crazyquark/bSafe/hardware/bSafe-charger-block/plots/bSafe-charger-block__Assembly.pdf

1 | 2 | 3 | 4 | 5 | 6

A

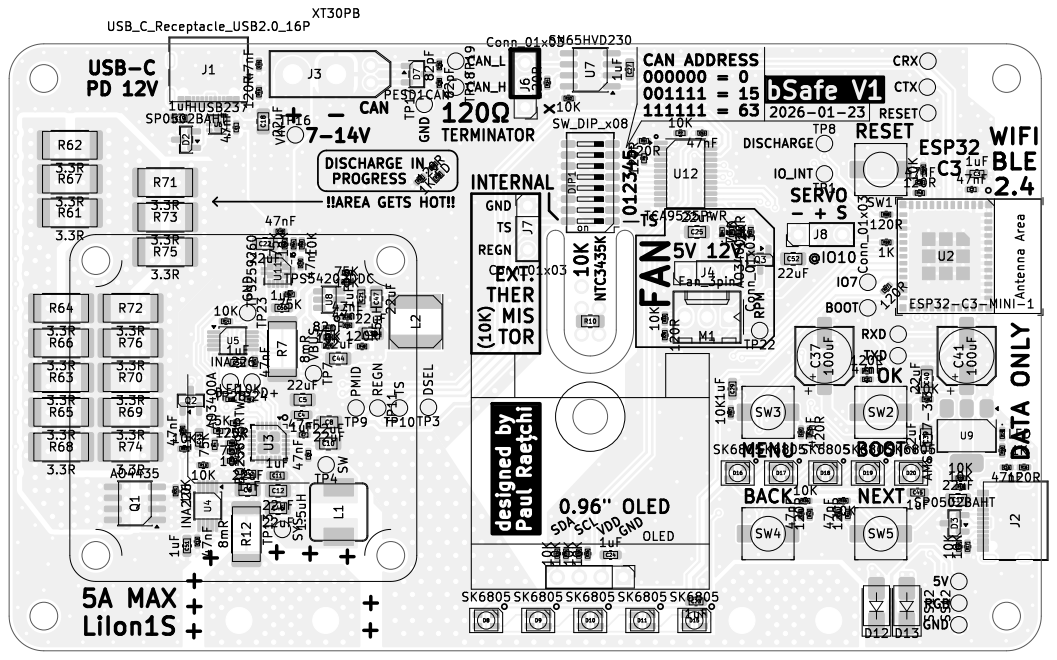
[picture p1: page 1]

!!AREA GETS HOT!! þÿ120©

REGN EXT. THER MIS

Id: /1 Title: File: bSafe-charger-block.kicad_pcb Sheet: Black And White TOP

CFG0 CFG1 1 | 2 | 3 | 4 | 5 | 6 1 | 2 | 3 | 4 | 5 | 6 ABCD | ABCD Date: KiCad | E.D.A. 9.0.7 Size: A4 | Rev:

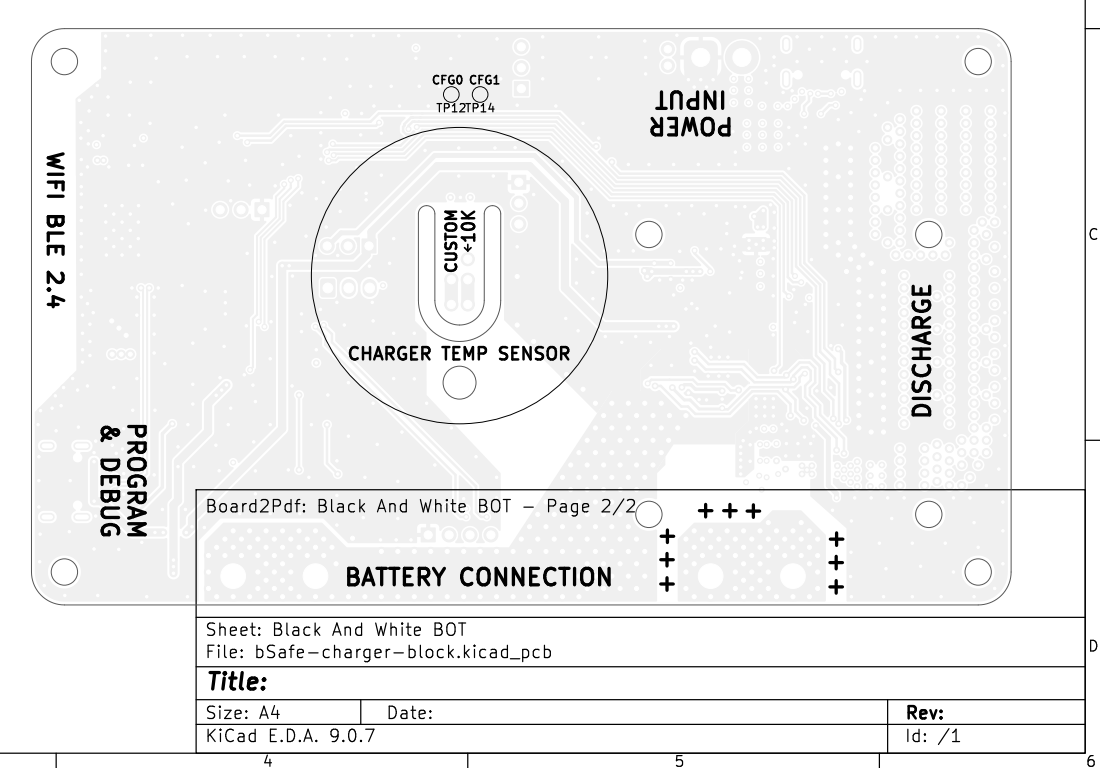
[picture p2: page 2]
CHARGER TEMP SENSOR; DISCHARGE WIFI BLE 2.4; &PROGRAM DEBUG; BATTERY CONNECTION; Id: /1 Title: File: bSafe-charger-block.kicad_pcb Sheet: Black; And; White; BOT Board2Pdf:; Black; BOT -; Page 2/2
