crazyquark/bSafe/hardware/bSafe-charger-block/bSafe-charger-block.kicad_pcb

## KiCad design hardware/bSafe-charger-block/bSafe-charger-block.kicad_pcb (2026-02-03)

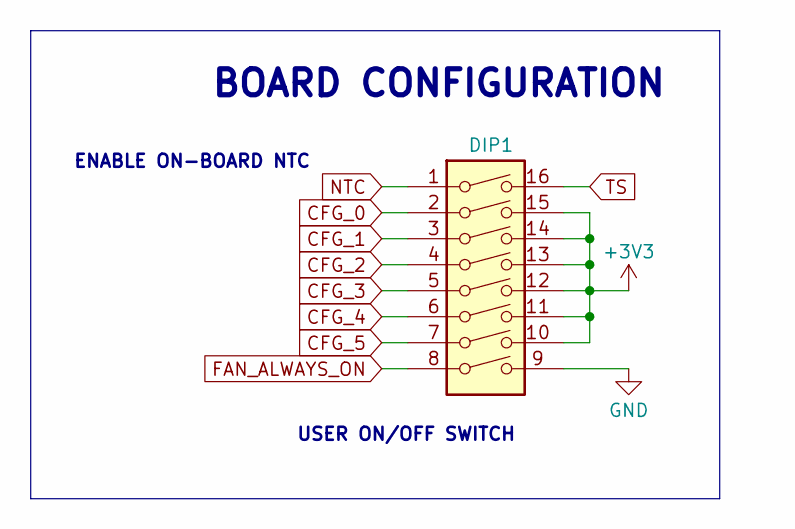
[picture p3: schematic config.kicad_sch]

Parts:
DIP1: SW_DIP_x08; SW_DIP_SPSTx08_Slide_Copal_CHS-08A_W5.08mm_P1.27mm_JPin

Connections:
+3V3: DIP1.10, DIP1.11, DIP1.12, DIP1.13, DIP1.14, DIP1.15; also elsewhere on the board
CFG_0: DIP1.2; also elsewhere on the board
CFG_1: DIP1.3; also elsewhere on the board
CFG_2: DIP1.4; also elsewhere on the board
CFG_3: DIP1.5; also elsewhere on the board
CFG_4: DIP1.6; also elsewhere on the board
CFG_5: DIP1.7; also elsewhere on the board
FAN_ALWAYS_ON: DIP1.8; also elsewhere on the board
GND: DIP1.9; also elsewhere on the board
NTC: DIP1.1; also elsewhere on the board
TS: DIP1.16; also elsewhere on the board

Notes on the sheet:
USER ON/OFF SWITCH
ENABLE ON-BOARD NTC
BOARD CONFIGURATION

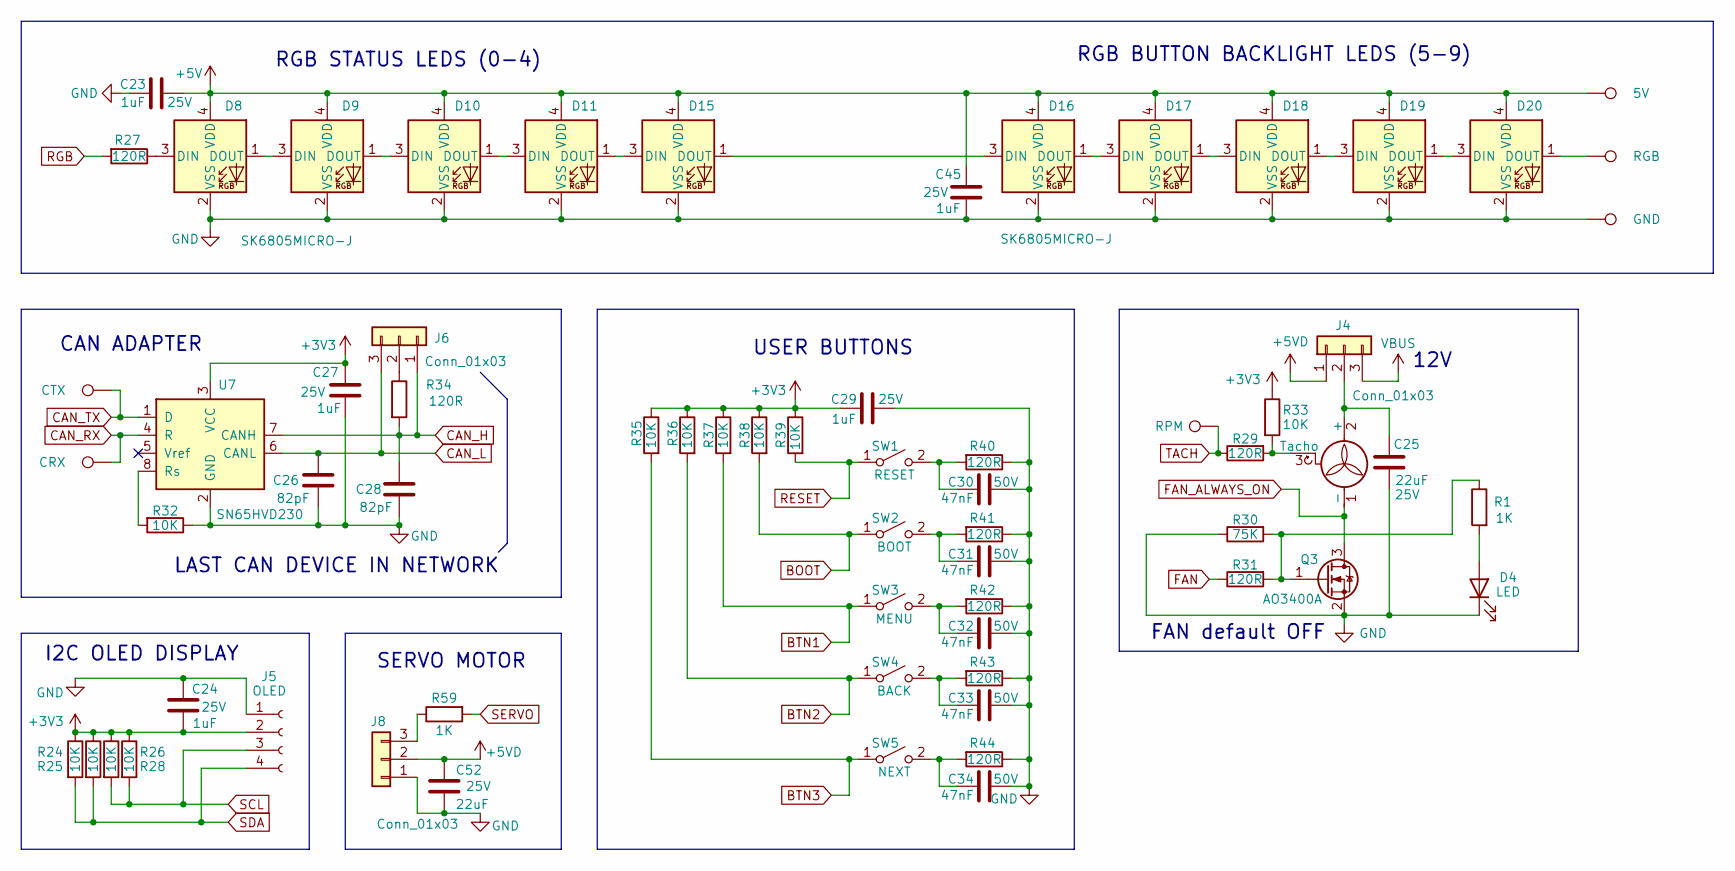
[picture p4: schematic interface.kicad_sch]

Parts:
C23, C24, C27, C29, C45: 1uF; C_0603_1608Metric; Voltage 25V
C25, C52: 22uF; C_0805_2012Metric; Voltage 25V
C26, C28: 82pF; C_0402_1005Metric
C30, C31, C32, C33, C34: 47nF; C_0402_1005Metric; Voltage 50V
D4: LED; LED_0402_1005Metric
D8, D9, D10, D11, D15, D16, D17, D18, D19, D20: SK6805MICRO-J; LED_SK6805_PLCC4_2.4x2.7mm_P1.3mm
J4, J6, J8: Conn_01x03; PinHeader_1x03_P2.54mm_Vertical
J5: OLED; Display_128x64_096_I2C
M1: Fan_3pin; Molex_KK-254_AE-6410-03A_1x03_P2.54mm_Vertical
Q3: AO3400A; SOT-23; JLCPCB C20917
R1, R59: 1K; R_0402_1005Metric
R24, R25, R26, R28, R32, R33, R35, R36, R37, R38, R39: 10K; R_0402_1005Metric
R27, R29, R31, R34, R40, R41, R42, R43, R44: 120R; R_0402_1005Metric
R30: 75K; R_0402_1005Metric
SW1: RESET; TS665WS
SW2: BOOT; TS665WS
SW3: MENU; TS665WS
SW4: BACK; TS665WS
SW5: NEXT; TS665WS
TP20: CTX; TestPoint_Pad_D1.5mm
TP21: CRX; TestPoint_Pad_D1.5mm
TP22: RPM; TestPoint_Pad_D1.5mm
TP25: 5V; TestPoint_Pad_D1.5mm
TP26: RGB; TestPoint_Pad_D1.5mm
TP27: GND; TestPoint_Pad_D1.5mm
U7: SN65HVD230; SOIC-8_3.9x4.9mm_P1.27mm

Connections:
+3V3: C24.2, C27.1, C29.2, J5.2, R24.1, R25.1, R26.1, R28.1, R33.1, R35.1, R36.1, R37.1, R38.1, R39.1, U7.3 (VCC); also elsewhere on the board
+5V: C23.1, C45.1, D8.4 (VDD), D9.4 (VDD), D10.4 (VDD), D11.4 (VDD), D15.4 (VDD), D16.4 (VDD), D17.4 (VDD), D18.4 (VDD), D19.4 (VDD), D20.4 (VDD), TP25.1; also elsewhere on the board
+5VD: C52.2, J4.1, J8.2; also elsewhere on the board
BOOT: R38.2, SW2.1 (A); also elsewhere on the board
BTN1: R37.2, SW3.1 (A); also elsewhere on the board
BTN2: R36.2, SW4.1 (A); also elsewhere on the board
BTN3: R35.2, SW5.1 (A); also elsewhere on the board
CAN_H: C28.1, J6.1, R34.2, U7.7 (CANH); also elsewhere on the board
CAN_L: C26.1, J6.3, U7.6 (CANL); also elsewhere on the board
CAN_RX: TP21.1, U7.4 (R); also elsewhere on the board
CAN_TX: TP20.1, U7.1 (D); also elsewhere on the board
FAN: R31.1; also elsewhere on the board
FAN_ALWAYS_ON: M1.1 (-), Q3.3 (D); also elsewhere on the board
GND: C23.2, C24.1, C25.2, C26.2, C27.2, C28.2, C29.1, C30.1, C31.1, C32.1, C33.1, C34.1, C45.2, C52.1, D4.1 (K), D8.2 (VSS), D9.2 (VSS), D10.2 (VSS), D11.2 (VSS), D15.2 (VSS), D16.2 (VSS), D17.2 (VSS), D18.2 (VSS), D19.2 (VSS), D20.2 (VSS), J5.1, J8.1, Q3.2 (S), R30.1, R32.1, R40.1, R41.1, R42.1, R43.1, R44.1, TP27.1, U7.2 (GND); also elsewhere on the board
unnamed: D4.2 (A), R1.2
unnamed: D8.3 (DIN), R27.1
unnamed: D8.1 (DOUT), D9.3 (DIN)
unnamed: D9.1 (DOUT), D10.3 (DIN)
unnamed: D10.1 (DOUT), D11.3 (DIN)
unnamed: D11.1 (DOUT), D15.3 (DIN)
unnamed: D15.1 (DOUT), D16.3 (DIN)
unnamed: D16.1 (DOUT), D17.3 (DIN)
unnamed: D17.1 (DOUT), D18.3 (DIN)
unnamed: D18.1 (DOUT), D19.3 (DIN)
unnamed: D19.1 (DOUT), D20.3 (DIN)
unnamed: D20.1 (DOUT), TP26.1
unnamed: C25.1, J4.2, M1.2 (+)
unnamed: J6.2, R34.1
unnamed: J8.3, R59.1
unnamed: M1.3 (Tacho), R29.2, R33.2
unnamed: Q3.1 (G), R1.1, R30.2, R31.2
unnamed: C30.2, R40.2, SW1.2 (B)
unnamed: C31.2, R41.2, SW2.2 (B)
unnamed: C32.2, R42.2, SW3.2 (B)
unnamed: C33.2, R43.2, SW4.2 (B)
unnamed: C34.2, R44.2, SW5.2 (B)
unnamed: R32.2, U7.8 (Rs)
RESET: R39.2, SW1.1 (A); also elsewhere on the board
RGB: R27.2; also elsewhere on the board
SCL: J5.3, R26.2, R28.2; also elsewhere on the board
SDA: J5.4, R24.2, R25.2; also elsewhere on the board
SERVO: R59.2; also elsewhere on the board
TACH: R29.1, TP22.1; also elsewhere on the board
VBUS: J4.3; also elsewhere on the board

Notes on the sheet:
I2C OLED DISPLAY
CAN ADAPTER
RGB STATUS LEDS (0-4)
SERVO MOTOR
RGB BUTTON BACKLIGHT LEDS (5-9)
FAN default OFF
12V
LAST CAN DEVICE IN NETWORK
USER BUTTONS

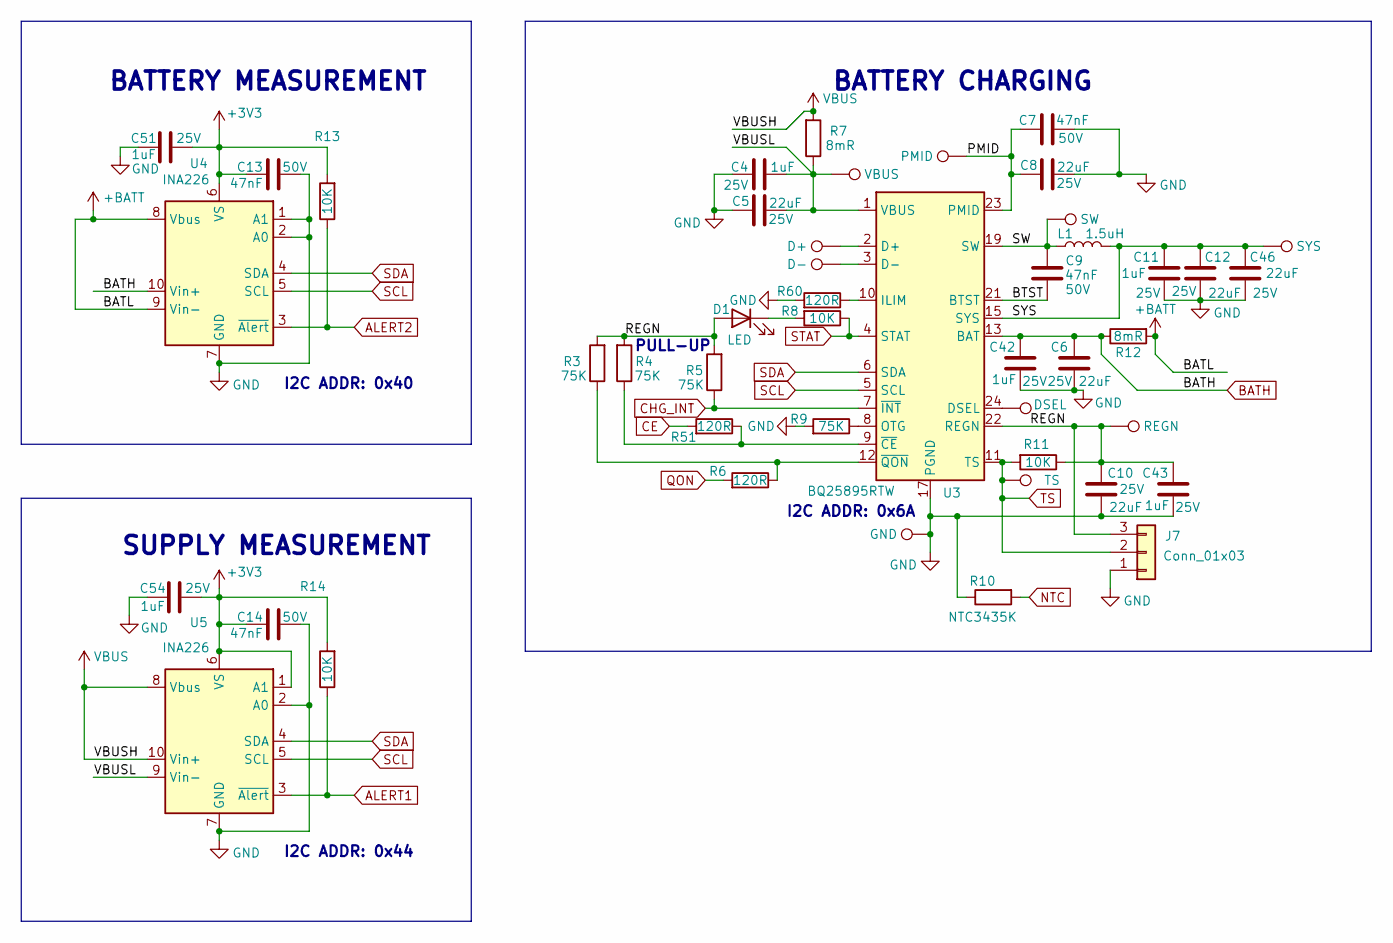
[picture p5: schematic charge.kicad_sch]

Parts:
C4, C11, C42, C43, C51, C54: 1uF; C_0603_1608Metric; Voltage 25V
C5, C6, C8, C10, C12, C46: 22uF; C_0805_2012Metric; Voltage 25V
C7, C9, C13, C14: 47nF; C_0402_1005Metric; Voltage 50V
D1: LED; LED_0402_1005Metric
J7: Conn_01x03; PinHeader_1x03_P2.54mm_Vertical
L1: 1.5uH; L_Sumida_CDMC6D28_7.25x6.5mm; JLCPCB C5189745
R3, R4, R5, R9: 75K; R_0402_1005Metric
R6, R51, R60: 120R; R_0402_1005Metric
R7, R12: 8mR; R_2512_6332Metric_Pad1.40x3.35mm_HandSolder
R8, R11, R13, R14: 10K; R_0402_1005Metric
R10: NTC3435K; R_0805_2012Metric_Pad1.20x1.40mm_HandSolder
TP3: DSEL; TestPoint_Pad_D1.5mm
TP4: SW; TestPoint_Pad_D1.5mm
TP7: VBUS; TestPoint_Pad_D1.5mm
TP9: PMID; TestPoint_Pad_D1.5mm
TP10: TS; TestPoint_Pad_D1.5mm
TP11: REGN; TestPoint_Pad_D1.5mm
TP13: SYS; TestPoint_Pad_D1.5mm
TP23: GND; TestPoint_Pad_D1.5mm
TP24: D+; TestPoint_Pad_D1.5mm
TP28: D-; TestPoint_Pad_D1.5mm
U3: BQ25895RTW; Texas_RTW_WQFN-24-1EP_4x4mm_P0.5mm_EP2.7x2.7mm_ThermalVias
U4, U5: INA226; VSSOP-10_3x3mm_P0.5mm

Connections:
+3V3: C13.2, C14.2, C51.1, C54.1, R13.2, R14.2, U4.6 (VS), U5.1 (A1), U5.6 (VS); also elsewhere on the board
+BATT: R12.2, U4.8 (Vbus), U4.9 (Vin-)
/charge/BTST: C9.1, U3.21 (BTST)
/charge/PMID: C7.2, C8.1, TP9.1, U3.23 (PMID)
/charge/REGN: C10.2, C43.2, D1.2 (A), J7.3, R3.2, R4.2, R5.2, R11.1, TP11.1, U3.22 (REGN)
/charge/SW: C9.2, L1.1, TP4.1, U3.19 (SW), U3.20 (SW)
/charge/SYS: C11.2, C12.1, C46.1, L1.2, TP13.1, U3.15 (SYS), U3.16 (SYS)
/charge/VBUSL: C4.1, C5.2, R7.1, TP7.1, U3.1 (VBUS), U5.9 (Vin-)
ALERT1: R14.1, U5.3 (~Alert); also elsewhere on the board
ALERT2: R13.1, U4.3 (~Alert); also elsewhere on the board
BATH: C6.1, C42.2, R12.1, U3.13 (BAT), U3.14 (BAT), U4.10 (Vin+); also elsewhere on the board
CE: R51.2; also elsewhere on the board
CHG_INT: R5.1, U3.7 (~INT); also elsewhere on the board
GND: C4.2, C5.1, C6.2, C7.1, C8.2, C10.1, C11.1, C12.2, C13.1, C14.1, C42.1, C43.1, C46.2, C51.2, C54.2, J7.1, R9.2, R10.1, R60.2, TP23.1, U3.17 (PGND), U3.18 (PGND), U3.25 (PGND), U4.1 (A1), U4.2 (A0), U4.7 (GND), U5.2 (A0), U5.7 (GND); also elsewhere on the board
NTC: R10.2; also elsewhere on the board
unnamed: D1.1 (K), R8.2
unnamed: TP24.1, U3.2 (D+)
unnamed: TP28.1, U3.3 (D-)
unnamed: TP3.1, U3.24 (DSEL)
unnamed: R60.1, U3.10 (ILIM)
unnamed: R9.1, U3.8 (OTG)
unnamed: R4.1, R51.1, U3.9 (~CE)
unnamed: R3.1, R6.1, U3.12 (~QON)
QON: R6.2; also elsewhere on the board
SCL: U3.5 (SCL), U4.5 (SCL), U5.5 (SCL); also elsewhere on the board
SDA: U3.6 (SDA), U4.4 (SDA), U5.4 (SDA); also elsewhere on the board
STAT: R8.1, U3.4 (STAT); also elsewhere on the board
TS: J7.2, R11.2, TP10.1, U3.11 (TS); also elsewhere on the board
VBUS: R7.2, U5.8 (Vbus), U5.10 (Vin+); also elsewhere on the board

Notes on the sheet:
SUPPLY MEASUREMENT
I2C ADDR: 0x44
I2C ADDR: 0x40
BATTERY CHARGING
I2C ADDR: 0x6A
PULL-UP
BATTERY MEASUREMENT

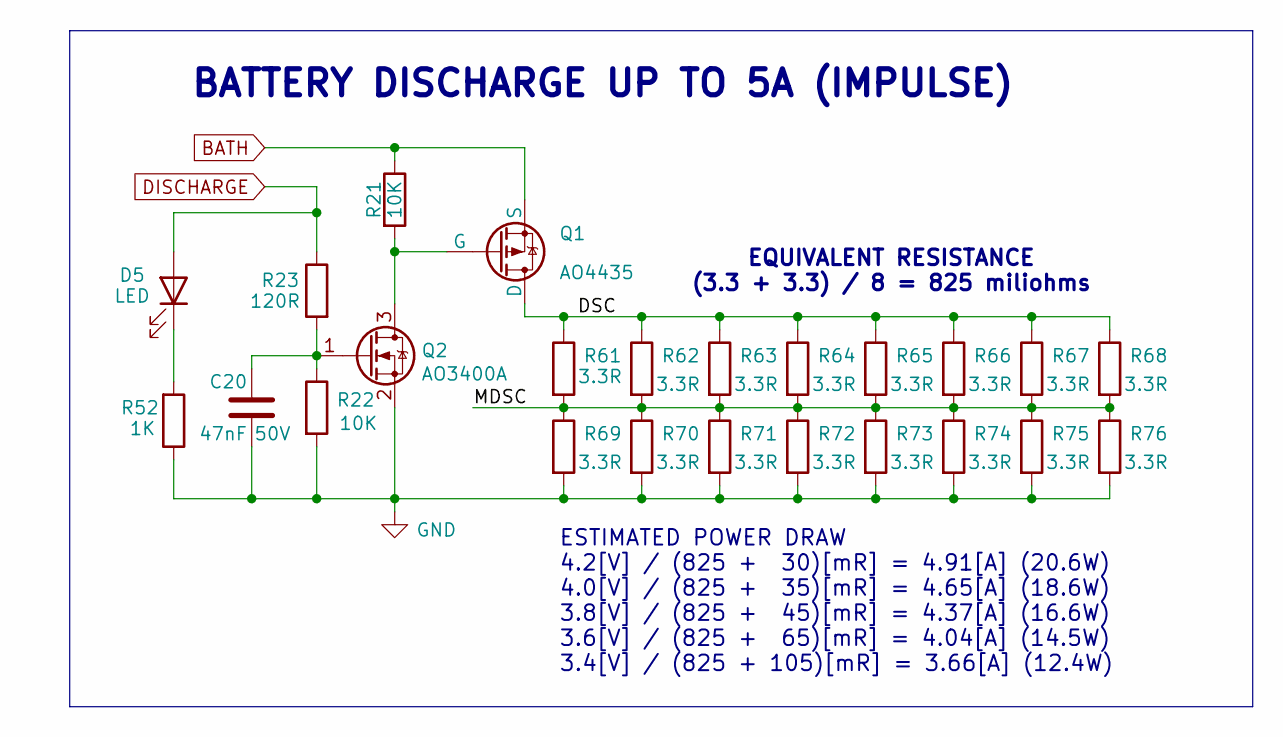
[picture p6: schematic discharge.kicad_sch]

Parts:
C20: 47nF; C_0402_1005Metric; Voltage 50V
D5: LED; LED_0402_1005Metric
Q1: AO4435; SOP-8_3.76x4.96mm_P1.27mm
Q2: AO3400A; SOT-23; JLCPCB C20917
R21, R22: 10K; R_0402_1005Metric
R23: 120R; R_0402_1005Metric
R52: 1K; R_0402_1005Metric
R61, R62, R63, R64, R65, R66, R67, R68, R69, R70, R71, R72, R73, R74, R75, R76: 3.3R; R_2512_6332Metric_Pad1.40x3.35mm_HandSolder

Connections:
/discharge/DSC: Q1.5 (D), Q1.6 (D), Q1.7 (D), Q1.8 (D), R61.1, R62.1, R63.1, R64.1, R65.1, R66.1, R67.1, R68.1
/discharge/MDSC: R61.2, R62.2, R63.2, R64.2, R65.2, R66.2, R67.2, R68.2, R69.1, R70.1, R71.1, R72.1, R73.1, R74.1, R75.1, R76.1
BATH: Q1.1 (S), Q1.2 (S), Q1.3 (S), R21.1; also elsewhere on the board
DISCHARGE: D5.2 (A), R23.1; also elsewhere on the board
GND: C20.2, Q2.2 (S), R22.2, R52.1, R69.2, R70.2, R71.2, R72.2, R73.2, R74.2, R75.2, R76.2; also elsewhere on the board
unnamed: D5.1 (K), R52.2
unnamed: Q1.4 (G), Q2.3 (D), R21.2
unnamed: C20.1, Q2.1 (G), R22.1, R23.2

Notes on the sheet:
EQUIVALENT RESISTANCE (3.3 + 3.3) / 8 = 825 miliohms
ESTIMATED POWER DRAW 4.2[V] / (825 + 30)[mR] = 4.91[A] (20.6W) 4.0[V] / (825 + 35)[mR] = 4.65[A] (18.6W) 3.8[V] / (825 + 45)[mR] = 4.37[A] (16.6W) 3.6[V] / (825 + 65)[mR] = 4.04[A] (14.5W) 3.4[V] / (825 + 105)[mR] = 3.66[A] (12.4W)
BATTERY DISCHARGE UP TO 5A (IMPULSE)

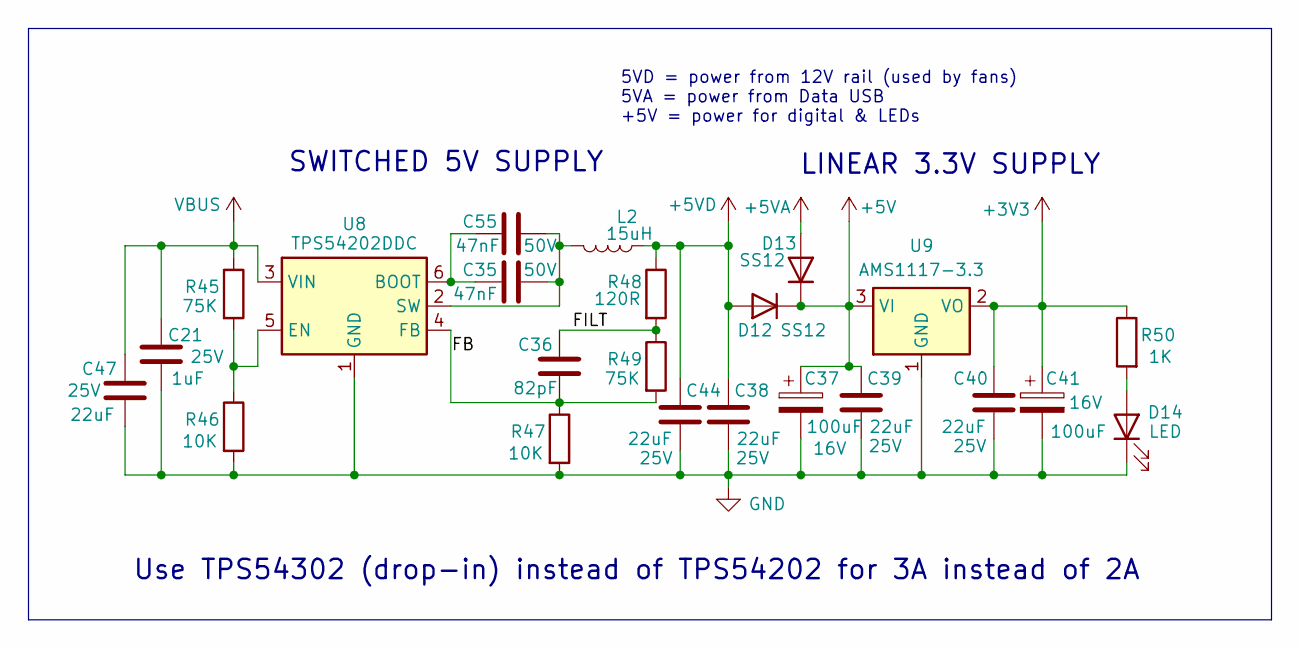
[picture p7: schematic supply.kicad_sch]

Parts:
C21: 1uF; C_0603_1608Metric; Voltage 25V
C35, C55: 47nF; C_0402_1005Metric; Voltage 50V
C36: 82pF; C_0402_1005Metric
C37, C41: 100uF; CP_Elec_6.3x5.4_Nichicon; Voltage 16V
C38, C39, C40, C44, C47: 22uF; C_0805_2012Metric; Voltage 25V
D12, D13: SS12; D_SMA
D14: LED; LED_0402_1005Metric
L2: 15uH; L_Taiyo-Yuden_NR-60xx
R45, R49: 75K; R_0402_1005Metric
R46, R47: 10K; R_0402_1005Metric
R48: 120R; R_0402_1005Metric
R50: 1K; R_0402_1005Metric
U8: TPS54202DDC; SOT-23-6
U9: AMS1117-3.3; SOT-223-3_TabPin2

Connections:
+3V3: C40.1, C41.1, R50.1, U9.2 (VO); also elsewhere on the board
+5V: C37.1, C39.1, D12.1 (K), D13.1 (K), U9.3 (VI); also elsewhere on the board
+5VA: D13.2 (A); also elsewhere on the board
+5VD: C38.1, C44.1, D12.2 (A), L2.2, R48.1; also elsewhere on the board
/supply/FB: C36.2, R47.1, R49.2, U8.4 (FB)
/supply/FILT: C36.1, R48.2, R49.1
GND: C21.2, C37.2, C38.2, C39.2, C40.2, C41.2, C44.2, C47.1, D14.1 (K), R46.2, R47.2, U8.1 (GND), U9.1 (GND); also elsewhere on the board
unnamed: D14.2 (A), R50.2
unnamed: C35.2, C55.2, U8.6 (BOOT)
unnamed: R45.2, R46.1, U8.5 (EN)
unnamed: C35.1, C55.1, L2.1, U8.2 (SW)
VBUS: C21.1, C47.2, R45.1, U8.3 (VIN); also elsewhere on the board

Notes on the sheet:
5VD = power from 12V rail (used by fans) 5VA = power from Data USB +5V = power for digital & LEDs
SWITCHED 5V SUPPLY
Use TPS54302 (drop-in) instead of TPS54202 for 3A instead of 2A
LINEAR 3.3V SUPPLY

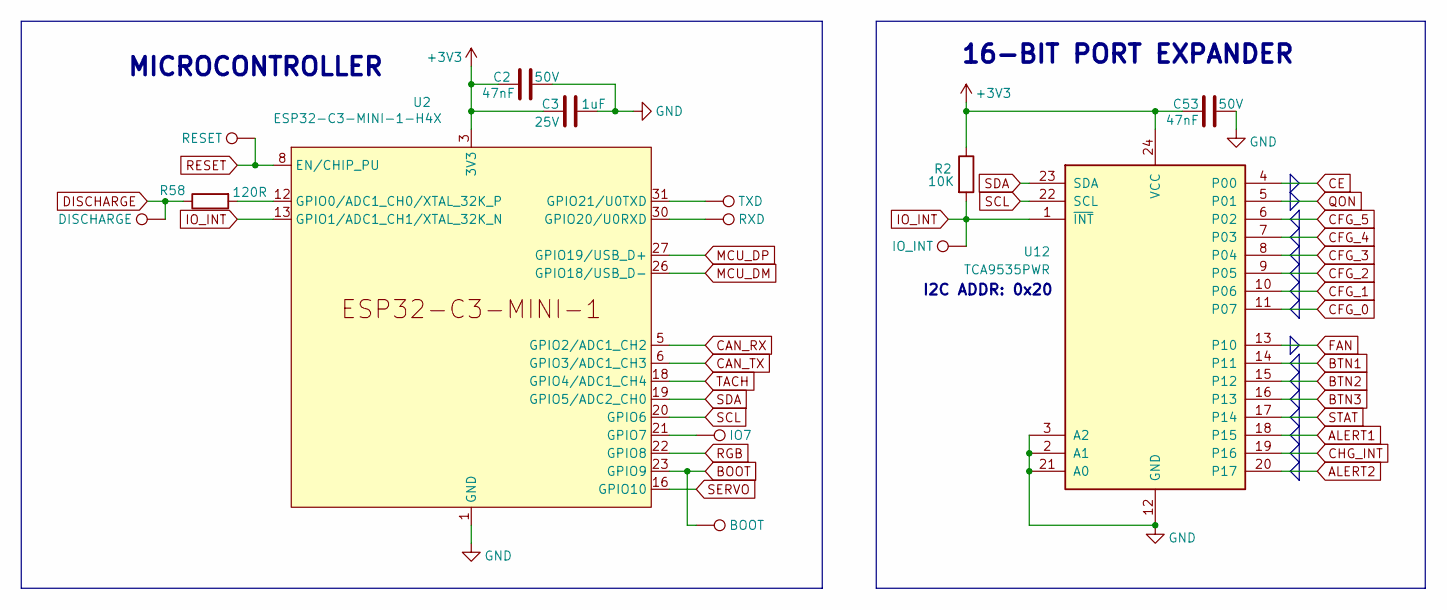
[picture p8: schematic logic.kicad_sch]

Parts:
C2, C53: 47nF; C_0402_1005Metric; Voltage 50V
C3: 1uF; C_0603_1608Metric; Voltage 25V
R2: 10K; R_0402_1005Metric
R58: 120R; R_0402_1005Metric
TP1: IO_INT; TestPoint_Pad_D1.5mm
TP2: IO7; TestPoint_Pad_D1.5mm
TP5: TXD; TestPoint_Pad_D1.5mm
TP6: RXD; TestPoint_Pad_D1.5mm
TP8: DISCHARGE; TestPoint_Pad_D1.5mm
TP30: RESET; TestPoint_Pad_D1.5mm
TP31: BOOT; TestPoint_Pad_D1.5mm
U2: ESP32-C3-MINI-1-H4X; ESP32-C3-MINI-1
U12: TCA9535PWR; TSSOP-24_4.4x7.8mm_P0.65mm

Connections:
+3V3: C2.2, C3.2, C53.2, R2.1, U2.3 (3V3), U12.24 (VCC); also elsewhere on the board
ALERT1: U12.18 (P15); also elsewhere on the board
ALERT2: U12.20 (P17); also elsewhere on the board
BOOT: TP31.1, U2.23 (GPIO9); also elsewhere on the board
BTN1: U12.14 (P11); also elsewhere on the board
BTN2: U12.15 (P12); also elsewhere on the board
BTN3: U12.16 (P13); also elsewhere on the board
CAN_RX: U2.5 (GPIO2/ADC1_CH2); also elsewhere on the board
CAN_TX: U2.6 (GPIO3/ADC1_CH3); also elsewhere on the board
CE: U12.4 (P00); also elsewhere on the board
CFG_0: U12.11 (P07); also elsewhere on the board
CFG_1: U12.10 (P06); also elsewhere on the board
CFG_2: U12.9 (P05); also elsewhere on the board
CFG_3: U12.8 (P04); also elsewhere on the board
CFG_4: U12.7 (P03); also elsewhere on the board
CFG_5: U12.6 (P02); also elsewhere on the board
CHG_INT: U12.19 (P16); also elsewhere on the board
DISCHARGE: R58.1, TP8.1; also elsewhere on the board
FAN: U12.13 (P10); also elsewhere on the board
GND: C2.1, C3.1, C53.1, U2.1 (GND), U2.2 (GND), U2.11 (GND), U2.14 (GND), U2.36 (GND), U2.37 (GND), U2.38 (GND), U2.39 (GND), U2.40 (GND), U2.41 (GND), U2.42 (GND), U2.43 (GND), U2.44 (GND), U2.45 (GND), U2.46 (GND), U2.47 (GND), U2.48 (GND), U2.49 (GND), U2.50 (GND), U2.51 (GND), U2.52 (GND), U2.53 (GND), U12.2 (A1), U12.3 (A2), U12.12 (GND), U12.21 (A0); also elsewhere on the board
IO_INT: R2.2, TP1.1, U2.13 (GPIO1/ADC1_CH1/XTAL_32K_N), U12.1 (~INT)
MCU_DM: U2.26 (GPIO18/USB_D-); also elsewhere on the board
MCU_DP: U2.27 (GPIO19/USB_D+); also elsewhere on the board
unnamed: R58.2, U2.12 (GPIO0/ADC1_CH0/XTAL_32K_P)
unnamed: TP2.1, U2.21 (GPIO7)
unnamed: TP6.1, U2.30 (GPIO20/U0RXD)
unnamed: TP5.1, U2.31 (GPIO21/U0TXD)
QON: U12.5 (P01); also elsewhere on the board
RESET: TP30.1, U2.8 (EN/CHIP_PU); also elsewhere on the board
RGB: U2.22 (GPIO8); also elsewhere on the board
SCL: U2.20 (GPIO6), U12.22 (SCL); also elsewhere on the board
SDA: U2.19 (GPIO5/ADC2_CH0), U12.23 (SDA); also elsewhere on the board
SERVO: U2.16 (GPIO10); also elsewhere on the board
STAT: U12.17 (P14); also elsewhere on the board
TACH: U2.18 (GPIO4/ADC1_CH4); also elsewhere on the board

Notes on the sheet:
MICROCONTROLLER
16-BIT PORT EXPANDER
I2C ADDR: 0x20

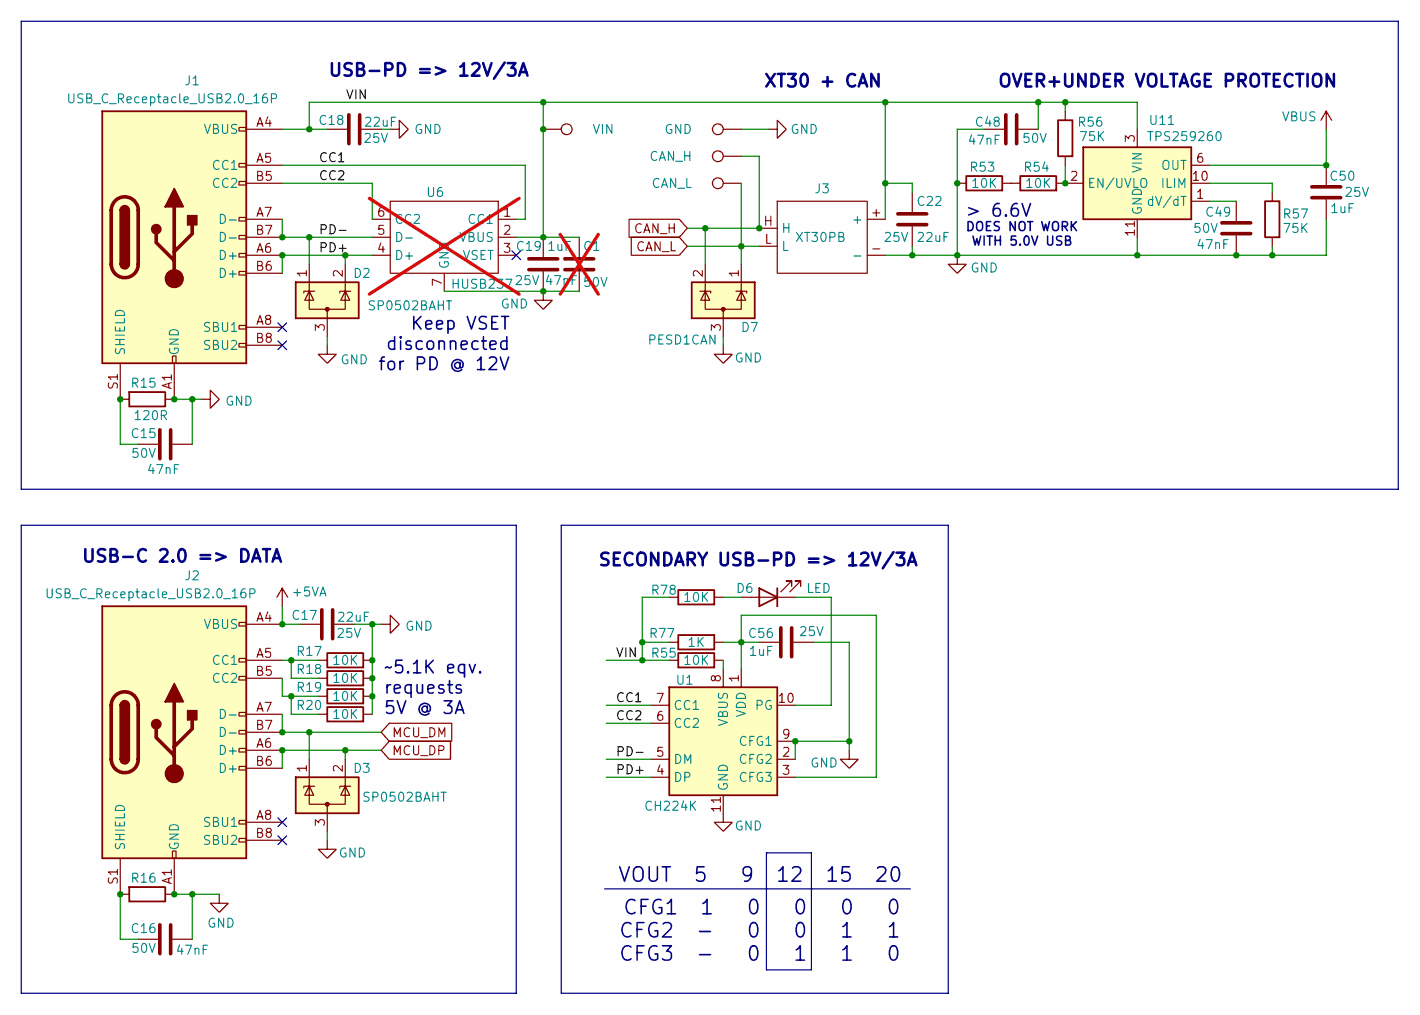
[picture p9: schematic inout.kicad_sch]

Parts:
C1: 47nF; C_0402_1005Metric; Voltage 50V; not fitted
C15, C16, C48, C49: 47nF; C_0402_1005Metric; Voltage 50V
C17, C18, C22: 22uF; C_0805_2012Metric; Voltage 25V
C19, C50, C56: 1uF; C_0603_1608Metric; Voltage 25V
D2, D3: SP0502BAHT; SOT-23
D6: LED; LED_0402_1005Metric
D7: PESD1CAN; SOT-23-3
J1, J2: USB_C_Receptacle_USB2.0_16P; USB_C_Receptacle_G-Switch_GT-USB-7010ASV
J3: XT30PB
R15, R16: 120R; R_0402_1005Metric
R17, R18, R19, R20, R53, R54, R55, R78: 10K; R_0402_1005Metric
R56, R57: 75K; R_0402_1005Metric
R77: 1K; R_0402_1005Metric
TP16: VIN; TestPoint_Pad_D1.5mm
TP17: GND; TestPoint_Pad_D1.5mm
TP18: CAN_H; TestPoint_Pad_D1.5mm
TP19: CAN_L; TestPoint_Pad_D1.5mm
U1: CH224K; SSOP-10-1EP_3.9x4.9mm_P1mm_EP2.1x3.3mm
U6: HUSB237; DFN-6-1EP_2x2mm_P0.65mm_EP1.01x1.7mm; not fitted
U11: TPS259260; VSON-10-1EP_3x3mm_P0.5mm_EP1.65x2.4mm_ThermalVias

Connections:
+5VA: C17.1, J2.A4 (VBUS), J2.A9 (VBUS), J2.B4 (VBUS), J2.B9 (VBUS); also elsewhere on the board
/input/CC1: J1.A5 (CC1), U1.7 (CC1), U6.1 (CC1)
/input/CC2: J1.B5 (CC2), U1.6 (CC2), U6.6 (CC2)
/input/PD+: D2.2 (K), J1.A6 (D+), J1.B6 (D+), U1.4 (DP), U6.4 (D+)
/input/PD-: D2.1 (K), J1.A7 (D-), J1.B7 (D-), U1.5 (DM), U6.5 (D-)
/input/VIN: C1.1, C18.1, C19.1, C22.2, C48.2, J1.A4 (VBUS), J1.A9 (VBUS), J1.B4 (VBUS), J1.B9 (VBUS), J3.+, R55.1, R56.1, R77.1, R78.1, TP16.1, U6.2 (VBUS), U11.3 (VIN), U11.4 (VIN), U11.5 (VIN)
CAN_H: D7.2 (K), J3.H, TP18.1; also elsewhere on the board
CAN_L: D7.1 (K), J3.L, TP19.1; also elsewhere on the board
GND: C1.2, C15.2, C16.2, C17.2, C18.2, C19.2, C22.1, C48.1, C49.1, C50.1, C56.1, D2.3 (A), D3.3 (A), D7.3 (A), J1.A1 (GND), J1.A12 (GND), J1.B1 (GND), J1.B12 (GND), J2.A1 (GND), J2.A12 (GND), J2.B1 (GND), J2.B12 (GND), J3.-, R15.1, R16.1, R17.2, R18.2, R19.2, R20.2, R53.1, R57.2, TP17.1, U1.2 (CFG2), U1.9 (CFG1), U1.11 (GND), U6.7 (GND), U11.11 (GND); also elsewhere on the board
MCU_DM: D3.1 (K), J2.A7 (D-), J2.B7 (D-); also elsewhere on the board
MCU_DP: D3.2 (K), J2.A6 (D+), J2.B6 (D+); also elsewhere on the board
unnamed: D6.2 (A), R78.2
unnamed: D6.1 (K), U1.10 (PG)
unnamed: C15.1, J1.S1 (SHIELD), R15.2
unnamed: J2.A5 (CC1), R17.1, R18.1
unnamed: J2.B5 (CC2), R19.1, R20.1
unnamed: C16.1, J2.S1 (SHIELD), R16.2
unnamed: R53.2, R54.1
unnamed: C56.2, R77.2, U1.1 (VDD), U1.3 (CFG3)
unnamed: R55.2, U1.8 (VBUS)
unnamed: R54.2, R56.2, U11.2 (EN/UVLO)
unnamed: R57.1, U11.10 (ILIM)
unnamed: C49.2, U11.1 (dV/dT)
VBUS: C50.2, U11.6 (OUT), U11.7 (OUT), U11.8 (OUT); also elsewhere on the board

Notes on the sheet:
VOUT 5 9 12 15 20
SECONDARY USB-PD => 12V/3A
DOES NOT WORK WITH 5.0V USB
USB-PD => 12V/3A
XT30 + CAN
> 6.6V
CFG1 1 0 0 0 0 CFG2 - 0 0 1 1 CFG3 - 0 1 1 0
USB-C 2.0 => DATA
~5.1K eqv. requests 5V @ 3A
Keep VSET disconnected for PD @ 12V
OVER+UNDER VOLTAGE PROTECTION

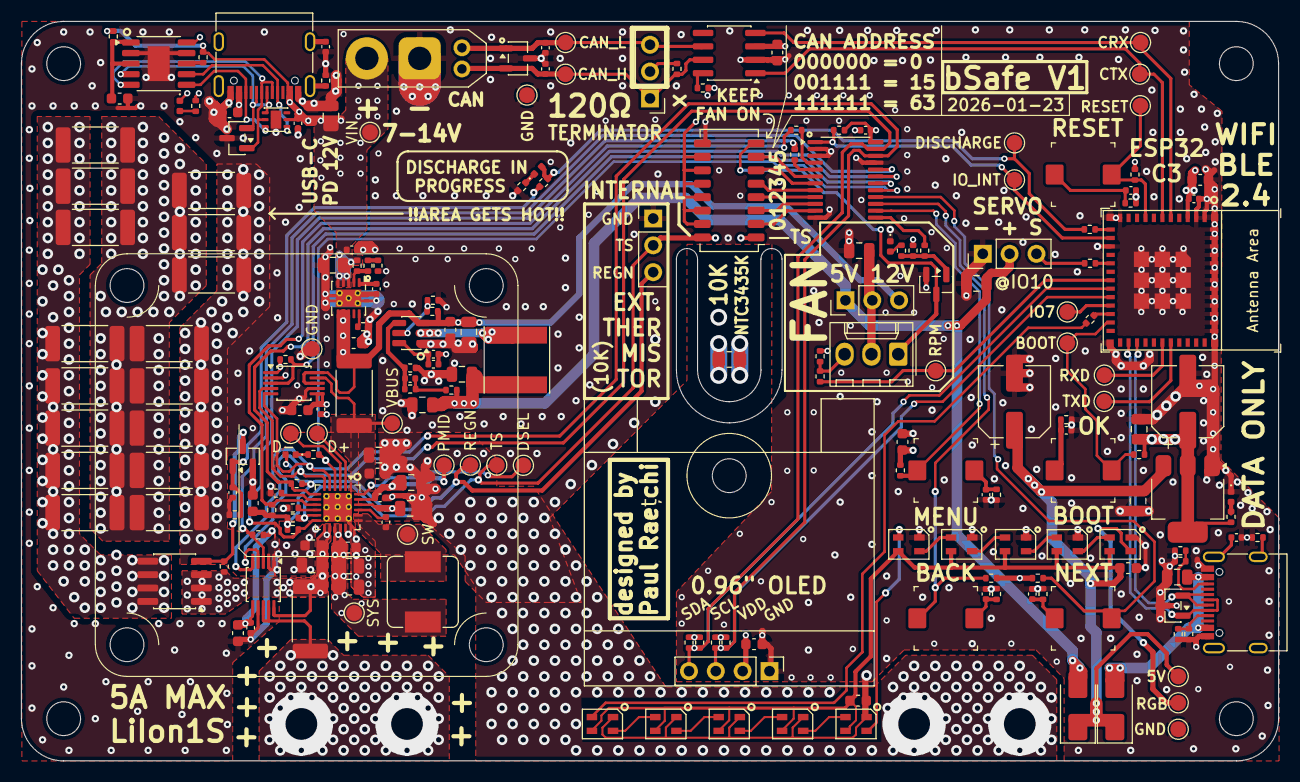
[picture p10: board bSafe-charger-block.kicad_pcb from above]

Board: 4 copper layers, 119.0 x 70.0 mm, 212 parts (0 on the bottom side), 111 nets.
