crazyquark/bSafe/(commit log)

2026-02-03 added hardware
    [bSafe-charger-block-B_Cu.gbr, bSafe-charger-block-B_Mask.gbr, bSafe-charger-block-B_Paste.gbr, bSafe-charger-block-B_Silkscreen.gbr, bSafe-charger-block-Edge_Cuts.gbr, bSafe-charger-block-F_Cu.gbr, bSafe-charger-block-F_Mask.gbr, bSafe-charger-block-F_Paste.gbr]
2026-02-23 nearing production stage
2026-03-02 calibrated NTC, added server (to be tested)
2026-03-11 server + devices working over wifi
2026-03-11 fix WiFi device overlap and charging not starting
    - Route OP/TELEM/IR frames by MAC (not CAN address) so two devices
    sharing the same NVS CAN address each update their own DeviceState
    - Key sessions and poll-loop lookups by ui_key for WiFi devices,
    fixing api_start_all sessions that were stored at ui_key but looked
    up at ws.address (CAN byte) — causing sessions to never tick
    - Resolve send_cmd target by ui_key first, falling back to CAN address,
    so commands reach the correct device when addresses collide
    - Use ui_key as session_key in on_status for battery/auto-mode events
    - Extend ui_key to full 48-bit MAC integer (was last-2-bytes only),
    eliminating ui_key collisions between de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
    [app.py, bsafe_wifi_host.py, engine.py]
2026-03-11 fix network_blueprint callbacks missing wifi_mac parameter
    The _on_status, _on_telem, and _on_ir wrapper closures in init_network()
    were not forwarding the new wifi_mac keyword argument added to the WiFi
    dispatch layer, causing a TypeError on every OP frame received.
    [network_blueprint.py]
2026-03-11 fix WiFi sink mode not charging: apply full BQ config before enabling
    _render_wifi_page was calling bq25895_set_charge_enable() directly,
    bypassing _apply_bq_for_charge(). This left VREG at the chip power-on
    default (~4.35 V) and IINLIM at the reset default (~200 mA), so the BQ
    either never entered fast-charge or severely current-limited the charge.
    Replace the inline BQ enable block with _apply_bq_for_charge(), which
    programs VREG, ICHG, IINLIM, IPRE and ITERM from NVS settings (same as
    the CAN charge page) before enabling CE. Non-BQ boards fall back to the
    GPIO CE path unchanged. Also explicitly disable CHG_CONFIG when
    chg_full_latched / chg_error_latched to ensure the BQ stops chargin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
    [app.c]
2026-03-11 revert BQ wifi charge to direct enable (keep watchdog kick)
    Reverts the _apply_bq_for_charge() delegation in _render_wifi_page back
    to the direct bq25895_set_hiz / set_charge_enable / watchdog_kick calls.
    [app.c]
